erickpires/seven-segments-clock/SevenSegmentClock/SevenSegmentClock.kicad_pcb

## KiCad design SevenSegmentClock/SevenSegmentClock.kicad_pcb (2024-02-11)

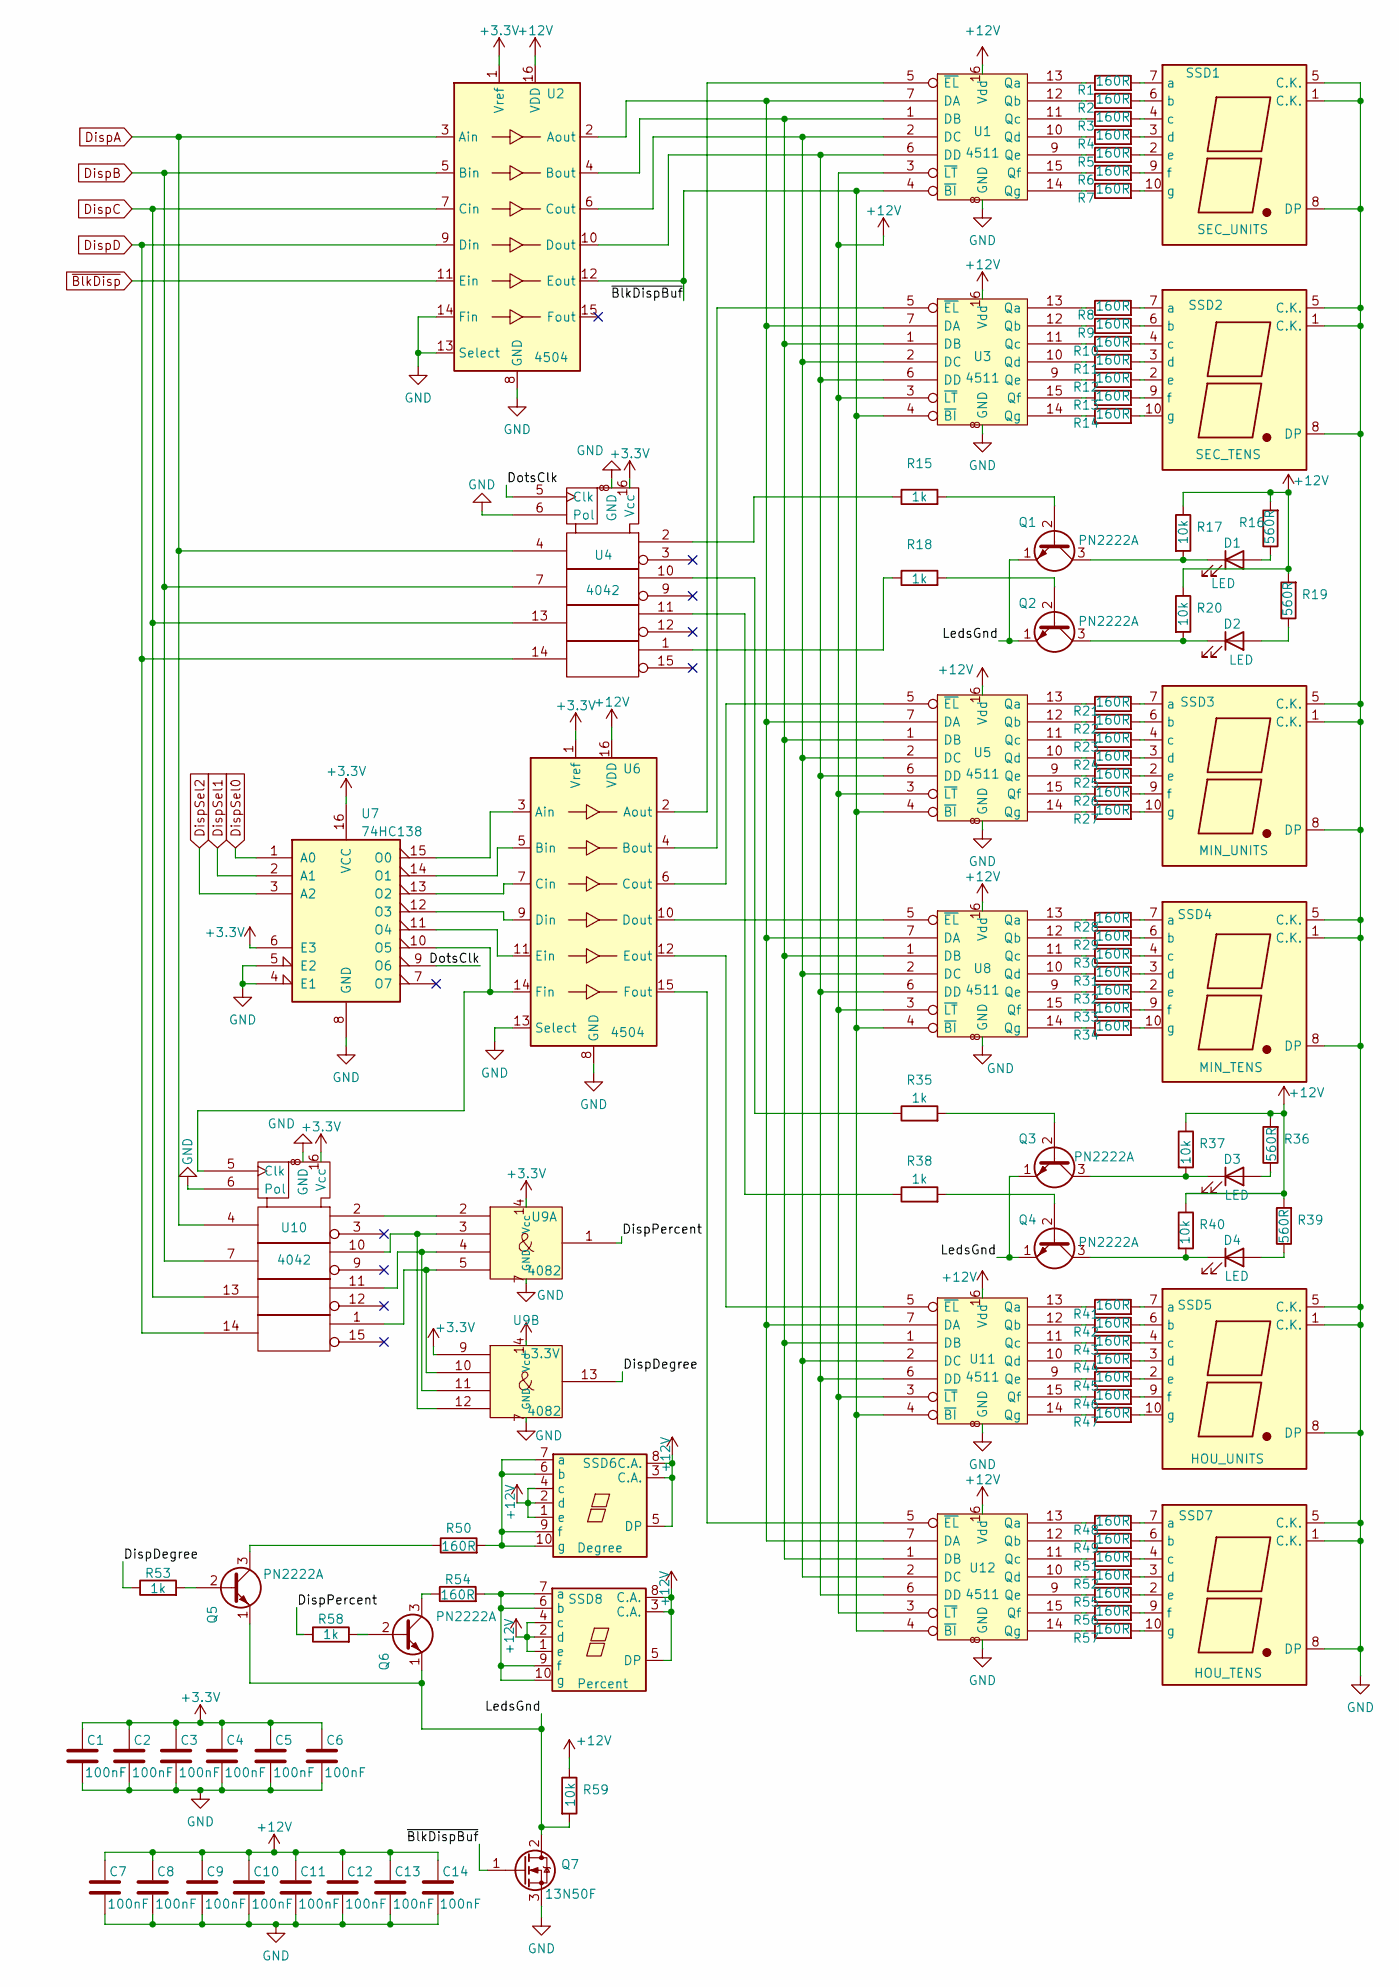
[picture p1: schematic display.kicad_sch]

Parts:
C1, C2, C3, C4, C5, C6, C7, C8, C9, C10, C11, C12, C13, C14: 100nF; C_1206_3216Metric_Pad1.33x1.80mm_HandSolder
D1, D2, D3, D4: LED; LED_D5.0mm
Q1, Q2, Q3, Q4, Q5, Q6: PN2222A; TO-92_Inline
Q7: 13N50F; TO-220-3_Vertical
R1, R2, R3, R4, R5, R6, R7, R8, R9, R10, R11, R12, R13, R14, R21, R22, R23, R24, R25, R26, R27, R28, R29, R30, R31, R32, R33, R34, R41, R42, R43, R44, R45, R46, R47, R48, R49, R50, R51, R52, R54, R55, R56, R57: 160R; R_1206_3216Metric_Pad1.30x1.75mm_HandSolder
R15, R18, R35, R38, R53, R58: 1k; R_1206_3216Metric_Pad1.30x1.75mm_HandSolder
R16, R19, R36, R39: 560R; R_Axial_DIN0207_L6.3mm_D2.5mm_P10.16mm_Horizontal
R17, R20, R37, R40, R59: 10k; R_Axial_DIN0207_L6.3mm_D2.5mm_P10.16mm_Horizontal
SSD1: SEC_UNITS; LSD230A
SSD2: SEC_TENS; LSD230A
SSD3: MIN_UNITS; LSD230A
SSD4: MIN_TENS; LSD230A
SSD5: HOU_UNITS; LSD230A
SSD6: Degree; 7SegmentLED_LTS6760_LTS6780
SSD7: HOU_TENS; LSD230A
SSD8: Percent; 7SegmentLED_LTS6760_LTS6780
U1, U3, U5, U8, U11, U12: 4511; SOIC-16_3.9x9.9mm_P1.27mm
U2, U6: 4504; SOIC-16_3.9x9.9mm_P1.27mm
U4, U10: 4042; DIP-16_W7.62mm_Socket_LongPads
U7: 74HC138; SOIC-16_3.9x9.9mm_P1.27mm
U9: 4082; DIP-14_W7.62mm_Socket_LongPads

Connections:
+3.3V: C1.1, C2.1, C3.1, C4.1, C5.1, C6.1, U2.1 (Vref), U4.16 (Vcc), U6.1 (Vref), U7.6 (E3), U7.16 (VCC), U9.9, U9.14 (Vcc), U10.16 (Vcc); also elsewhere on the board
+12V: C7.1, C8.1, C9.1, C10.1, C11.1, C12.1, C13.1, C14.1, R16.2, R17.1, R19.2, R20.1, R36.2, R37.1, R39.2, R40.1, R59.1, SSD6.1 (e), SSD6.2 (d), SSD6.3 (C.A.), SSD6.4 (c), SSD6.5 (DP), SSD6.8 (C.A.), SSD8.1 (e), SSD8.2 (d), SSD8.3 (C.A.), SSD8.4 (c), SSD8.5 (DP), SSD8.8 (C.A.), U1.3 (~LT), U1.16 (Vdd), U2.16 (VDD), U3.3 (~LT), U3.16 (Vdd), U5.3 (~LT), U5.16 (Vdd), U6.16 (VDD), U8.3 (~LT), U8.16 (Vdd), U11.3 (~LT), U11.16 (Vdd), U12.3 (~LT), U12.16 (Vdd); also elsewhere on the board
/Display/DispDegree: R53.1, U9.13
/Display/DispPercent: R58.1, U9.1
/Display/DotsClk: U4.5 (Clk), U7.9 (O6)
/Display/LedsGnd: Q1.1 (E), Q2.1 (E), Q3.1 (E), Q4.1 (E), Q5.1 (E), Q6.1 (E), Q7.2 (D), R59.2
/Display/~BlkDispBuf: Q7.1 (G), U1.4 (~BI), U2.12 (Eout), U3.4 (~BI), U5.4 (~BI), U8.4 (~BI), U11.4 (~BI), U12.4 (~BI)
DispA: U2.3 (Ain), U4.4, U10.4; also elsewhere on the board
DispB: U2.5 (Bin), U4.7, U10.7; also elsewhere on the board
DispC: U2.7 (Cin), U4.13, U10.13; also elsewhere on the board
DispD: U2.9 (Din), U4.14, U10.14; also elsewhere on the board
DispSel0: U7.1 (A0); also elsewhere on the board
DispSel1: U7.2 (A1); also elsewhere on the board
DispSel2: U7.3 (A2); also elsewhere on the board
GND: C1.2, C2.2, C3.2, C4.2, C5.2, C6.2, C7.2, C8.2, C9.2, C10.2, C11.2, C12.2, C13.2, C14.2, Q7.3 (S), SSD1.1 (C.K.), SSD1.5 (C.K.), SSD1.8 (DP), SSD2.1 (C.K.), SSD2.5 (C.K.), SSD2.8 (DP), SSD3.1 (C.K.), SSD3.5 (C.K.), SSD3.8 (DP), SSD4.1 (C.K.), SSD4.5 (C.K.), SSD4.8 (DP), SSD5.1 (C.K.), SSD5.5 (C.K.), SSD5.8 (DP), SSD7.1 (C.K.), SSD7.5 (C.K.), SSD7.8 (DP), U1.8 (GND), U2.8 (GND), U2.13 (Select), U2.14 (Fin), U3.8 (GND), U4.6 (Pol), U4.8 (GND), U5.8 (GND), U6.8 (GND), U6.13 (Select), U7.4 (E1), U7.5 (E2), U7.8 (GND), U8.8 (GND), U9.7 (GND), U10.6 (Pol), U10.8 (GND), U11.8 (GND), U12.8 (GND); also elsewhere on the board
unnamed: D1.2 (A), R16.1
unnamed: D1.1 (K), Q1.3 (C), R17.2
unnamed: D2.2 (A), R19.1
unnamed: D2.1 (K), Q2.3 (C), R20.2
unnamed: D3.2 (A), R36.1
unnamed: D3.1 (K), Q3.3 (C), R37.2
unnamed: D4.2 (A), R39.1
unnamed: D4.1 (K), Q4.3 (C), R40.2
unnamed: Q1.2 (B), R15.2
unnamed: Q2.2 (B), R18.2
unnamed: Q3.2 (B), R35.2
unnamed: Q4.2 (B), R38.2
unnamed: Q5.2 (B), R53.2
unnamed: Q5.3 (C), R50.1
unnamed: Q6.2 (B), R58.2
unnamed: Q6.3 (C), R54.1
unnamed: R15.1, U4.2
unnamed: R18.1, U4.1
unnamed: R35.1, U4.10
unnamed: R38.1, U4.11
unnamed: R1.2, SSD1.7 (a)
unnamed: R2.2, SSD1.6 (b)
unnamed: R3.2, SSD1.4 (c)
unnamed: R4.2, SSD1.3 (d)
unnamed: R5.2, SSD1.2 (e)
unnamed: R6.2, SSD1.9 (f)
unnamed: R7.2, SSD1.10 (g)
unnamed: R8.2, SSD2.7 (a)
unnamed: R9.2, SSD2.6 (b)
unnamed: R10.2, SSD2.4 (c)
unnamed: R11.2, SSD2.3 (d)
unnamed: R12.2, SSD2.2 (e)
unnamed: R13.2, SSD2.9 (f)
unnamed: R14.2, SSD2.10 (g)
unnamed: R21.2, SSD3.7 (a)
unnamed: R22.2, SSD3.6 (b)
unnamed: R23.2, SSD3.4 (c)
unnamed: R24.2, SSD3.3 (d)
unnamed: R25.2, SSD3.2 (e)
unnamed: R26.2, SSD3.9 (f)
unnamed: R27.2, SSD3.10 (g)
unnamed: R28.2, SSD4.7 (a)
unnamed: R29.2, SSD4.6 (b)
unnamed: R30.2, SSD4.4 (c)
unnamed: R31.2, SSD4.3 (d)
unnamed: R32.2, SSD4.2 (e)
unnamed: R33.2, SSD4.9 (f)
unnamed: R34.2, SSD4.10 (g)
unnamed: R41.2, SSD5.7 (a)
unnamed: R42.2, SSD5.6 (b)
unnamed: R43.2, SSD5.4 (c)
unnamed: R44.2, SSD5.3 (d)
unnamed: R45.2, SSD5.2 (e)
unnamed: R46.2, SSD5.9 (f)
unnamed: R47.2, SSD5.10 (g)
unnamed: R50.2, SSD6.6 (b), SSD6.7 (a), SSD6.9 (f), SSD6.10 (g)
unnamed: R48.2, SSD7.7 (a)
unnamed: R49.2, SSD7.6 (b)
unnamed: R51.2, SSD7.4 (c)
unnamed: R52.2, SSD7.3 (d)
unnamed: R55.2, SSD7.2 (e)
unnamed: R56.2, SSD7.9 (f)
unnamed: R57.2, SSD7.10 (g)
unnamed: R54.2, SSD8.6 (b), SSD8.7 (a), SSD8.9 (f), SSD8.10 (g)
unnamed: U1.7 (DA), U2.2 (Aout), U3.7 (DA), U5.7 (DA), U8.7 (DA), U11.7 (DA), U12.7 (DA)
unnamed: U1.1 (DB), U2.4 (Bout), U3.1 (DB), U5.1 (DB), U8.1 (DB), U11.1 (DB), U12.1 (DB)
unnamed: U1.2 (DC), U2.6 (Cout), U3.2 (DC), U5.2 (DC), U8.2 (DC), U11.2 (DC), U12.2 (DC)
unnamed: U1.6 (DD), U2.10 (Dout), U3.6 (DD), U5.6 (DD), U8.6 (DD), U11.6 (DD), U12.6 (DD)
unnamed: R1.1, U1.13 (Qa)
unnamed: R2.1, U1.12 (Qb)
unnamed: R3.1, U1.11 (Qc)
unnamed: R4.1, U1.10 (Qd)
unnamed: R5.1, U1.9 (Qe)
unnamed: R6.1, U1.15 (Qf)
unnamed: R7.1, U1.14 (Qg)
unnamed: U1.5 (~EL), U6.2 (Aout)
unnamed: R8.1, U3.13 (Qa)
unnamed: R9.1, U3.12 (Qb)
unnamed: R10.1, U3.11 (Qc)
unnamed: R11.1, U3.10 (Qd)
unnamed: R12.1, U3.9 (Qe)
unnamed: R13.1, U3.15 (Qf)
unnamed: R14.1, U3.14 (Qg)
unnamed: U3.5 (~EL), U6.4 (Bout)
unnamed: R21.1, U5.13 (Qa)
unnamed: R22.1, U5.12 (Qb)
unnamed: R23.1, U5.11 (Qc)
unnamed: R24.1, U5.10 (Qd)
unnamed: R25.1, U5.9 (Qe)
unnamed: R26.1, U5.15 (Qf)
unnamed: R27.1, U5.14 (Qg)
unnamed: U5.5 (~EL), U6.6 (Cout)
unnamed: U6.3 (Ain), U7.15 (O0)
unnamed: U6.5 (Bin), U7.14 (O1)
unnamed: U6.7 (Cin), U7.13 (O2)
unnamed: U6.9 (Din), U7.12 (O3)
unnamed: U6.10 (Dout), U8.5 (~EL)
unnamed: U6.11 (Ein), U7.11 (O4)
unnamed: R28.1, U8.13 (Qa)
unnamed: R29.1, U8.12 (Qb)
unnamed: R30.1, U8.11 (Qc)
unnamed: R31.1, U8.10 (Qd)
unnamed: R32.1, U8.9 (Qe)
unnamed: R33.1, U8.15 (Qf)
unnamed: R34.1, U8.14 (Qg)
unnamed: U6.14 (Fin), U7.10 (O5), U10.5 (Clk)
unnamed: U9.5, U9.10, U10.1
unnamed: U9.2, U10.2
unnamed: U9.3, U9.12, U10.10
unnamed: U9.4, U9.11, U10.11
unnamed: R41.1, U11.13 (Qa)
unnamed: R42.1, U11.12 (Qb)
unnamed: R43.1, U11.11 (Qc)
unnamed: R44.1, U11.10 (Qd)
unnamed: R45.1, U11.9 (Qe)
unnamed: R46.1, U11.15 (Qf)
unnamed: R47.1, U11.14 (Qg)
unnamed: U6.12 (Eout), U11.5 (~EL)
unnamed: R48.1, U12.13 (Qa)
unnamed: R49.1, U12.12 (Qb)
unnamed: R51.1, U12.11 (Qc)
unnamed: R52.1, U12.10 (Qd)
unnamed: R55.1, U12.9 (Qe)
unnamed: R56.1, U12.15 (Qf)
unnamed: R57.1, U12.14 (Qg)
unnamed: U6.15 (Fout), U12.5 (~EL)
~BlkDisp: U2.11 (Ein); also elsewhere on the board

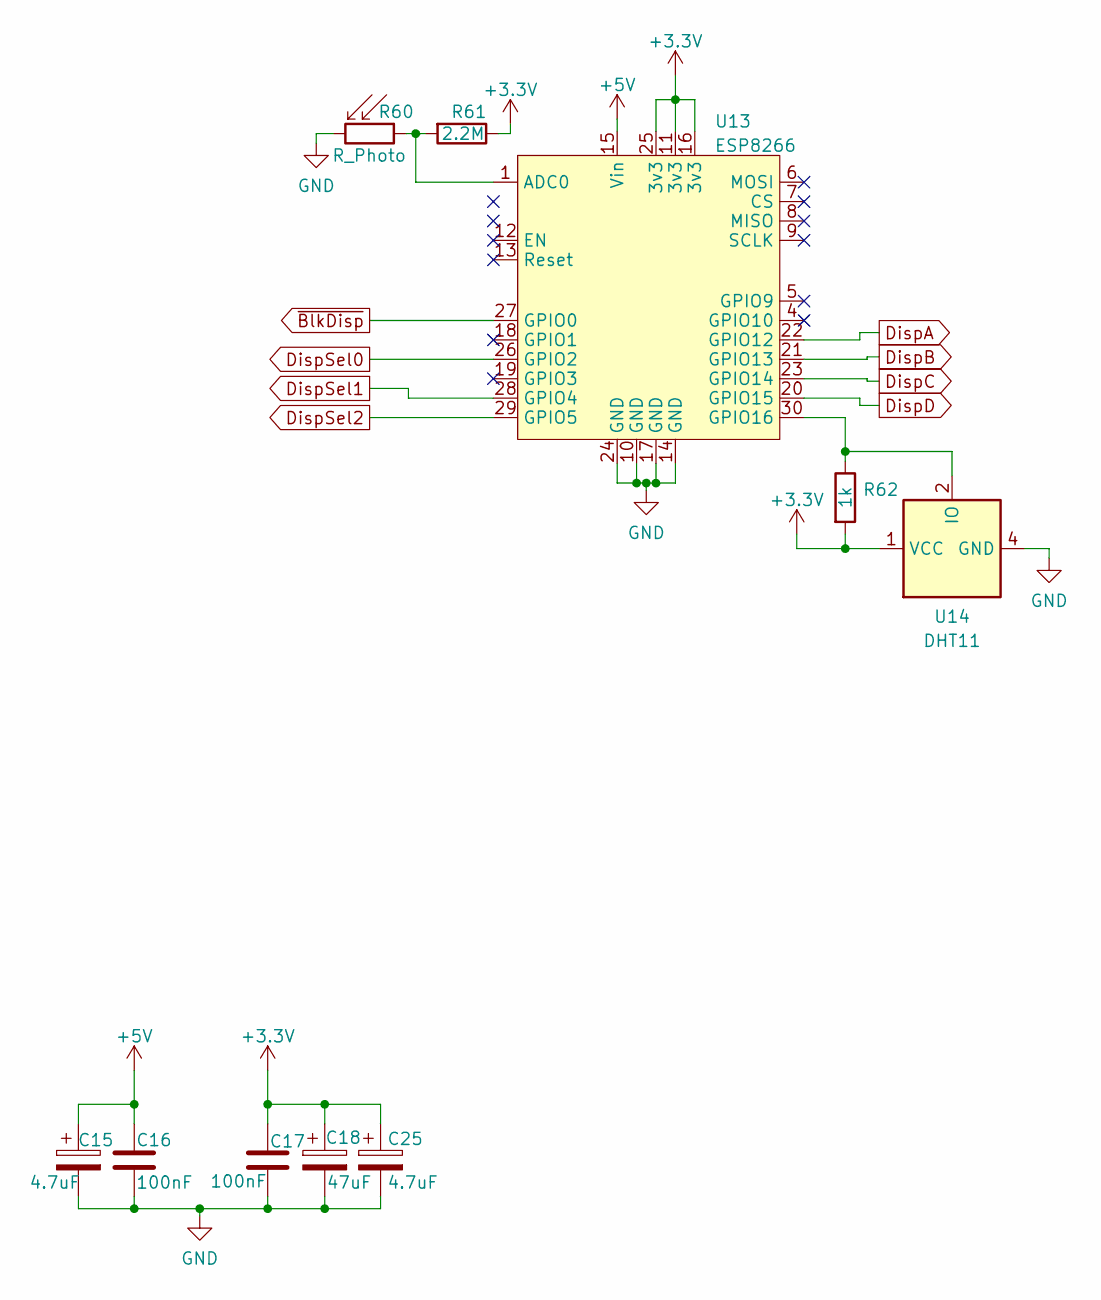
[picture p2: schematic control.kicad_sch]

Parts:
C15, C25: 4.7uF; CP_Radial_D6.3mm_P2.50mm
C16, C17: 100nF; C_1206_3216Metric_Pad1.33x1.80mm_HandSolder
C18: 47uF; CP_Radial_D6.3mm_P2.50mm
R60: R_Photo; R_LDR_4.9x4.2mm_P2.54mm_Vertical
R61: 2.2M; R_Axial_DIN0207_L6.3mm_D2.5mm_P10.16mm_Horizontal
R62: 1k; R_1206_3216Metric_Pad1.30x1.75mm_HandSolder
U13: ESP8266; ESP8266 (NodeMCU_12-E)
U14: DHT11; Aosong_DHT11_5.5x12.0_P2.54mm

Connections:
+3.3V: C17.1, C18.1, C25.1, R61.1, R62.2, U13.11 (3v3), U13.16 (3v3), U13.25 (3v3), U14.1 (VCC); also elsewhere on the board
+5V: C15.1, C16.1, U13.15 (Vin); also elsewhere on the board
DispA: U13.22 (GPIO12); also elsewhere on the board
DispB: U13.21 (GPIO13); also elsewhere on the board
DispC: U13.23 (GPIO14); also elsewhere on the board
DispD: U13.20 (GPIO15); also elsewhere on the board
DispSel0: U13.26 (GPIO2); also elsewhere on the board
DispSel1: U13.28 (GPIO4); also elsewhere on the board
DispSel2: U13.29 (GPIO5); also elsewhere on the board
GND: C15.2, C16.2, C17.2, C18.2, C25.2, R60.2, U13.10 (GND), U13.14 (GND), U13.17 (GND), U13.24 (GND), U14.4 (GND); also elsewhere on the board
unnamed: R60.1, R61.2, U13.1 (ADC0)
unnamed: R62.1, U13.30 (GPIO16), U14.2 (IO)
~BlkDisp: U13.27 (GPIO0); also elsewhere on the board

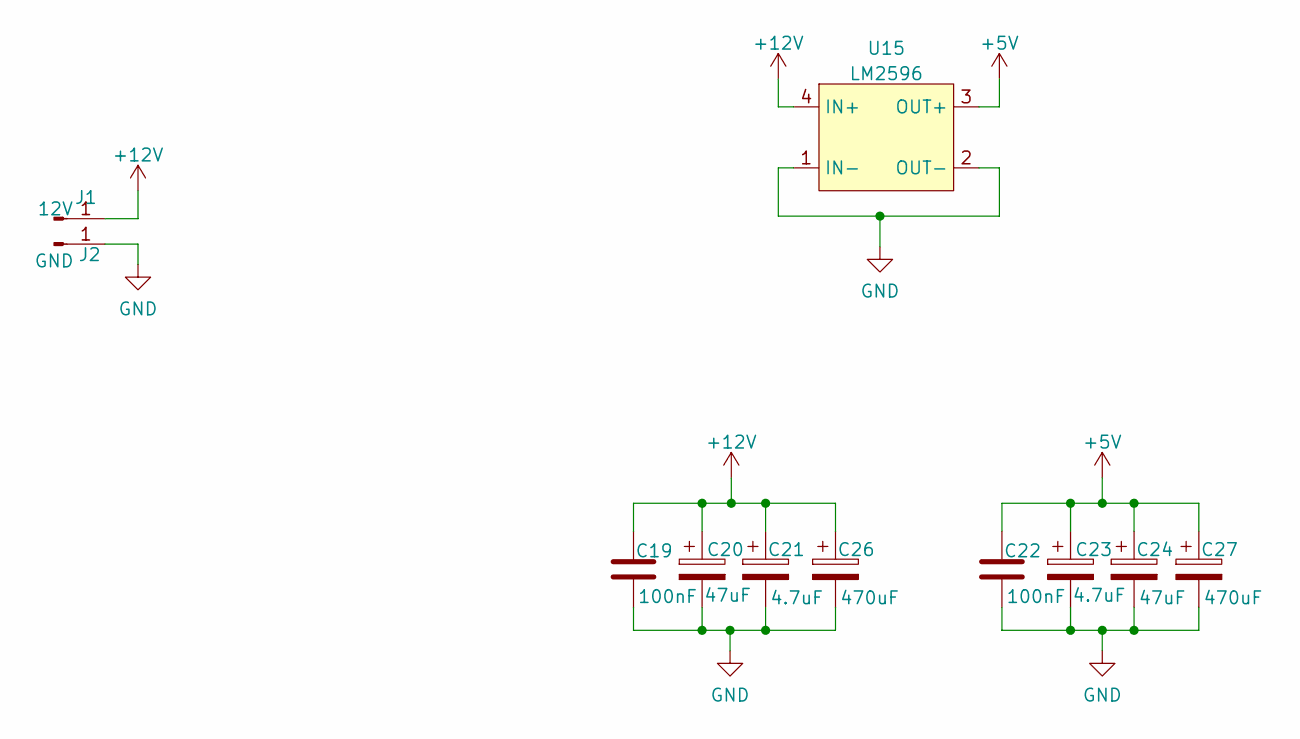
[picture p3: schematic power.kicad_sch]

Parts:
C19, C22: 100nF; C_1206_3216Metric_Pad1.33x1.80mm_HandSolder
C20, C24: 47uF; CP_Radial_D6.3mm_P2.50mm
C21, C23: 4.7uF; CP_Radial_D6.3mm_P2.50mm
C26, C27: 470uF; CP_Radial_D10.0mm_P5.00mm
J1: 12V; PinHeader_1x01_P2.54mm_Vertical
J2: GND; PinHeader_1x01_P2.54mm_Vertical
U15: LM2596

Connections:
+5V: C22.1, C23.1, C24.1, C27.1, U15.3 (OUT+); also elsewhere on the board
+12V: C19.1, C20.1, C21.1, C26.1, J1.1, U15.4 (IN+); also elsewhere on the board
GND: C19.2, C20.2, C21.2, C22.2, C23.2, C24.2, C26.2, C27.2, J2.1, U15.1 (IN-), U15.2 (OUT-); also elsewhere on the board

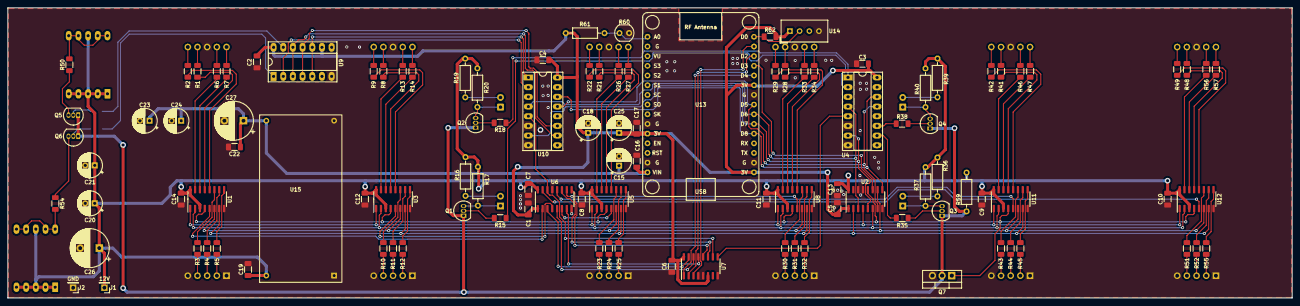
[picture p4: board SevenSegmentClock.kicad_pcb from above]

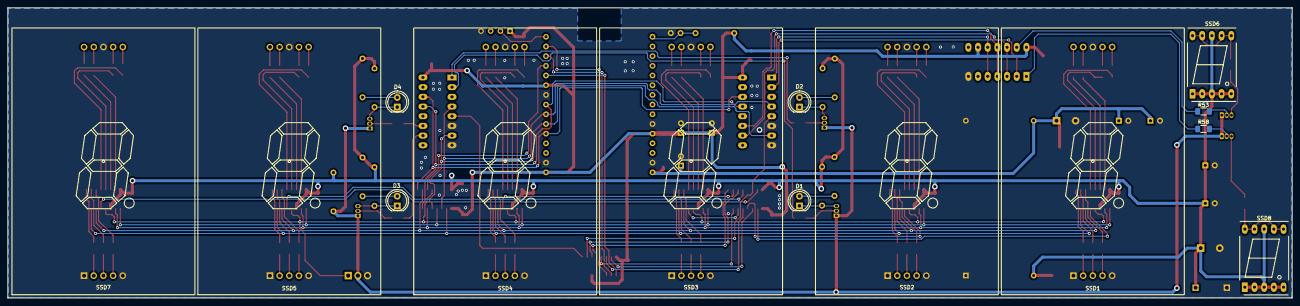
[picture p5: board SevenSegmentClock.kicad_pcb from below]

Board: 2 copper layers, 337.0 x 76.1 mm, 125 parts (14 on the bottom side), 145 nets.
