erickpires/seven-segments-clock/ESP8266/src/Main/types.h

#ifndef M_TYPES_H
#define M_TYPES_H 1

#include <stdint.h>


#include <stdint.h>
#include <stddef.h>
#include <stdbool.h>

typedef intptr_t isize;
typedef int8_t int8;
typedef int16_t int16;
typedef int32_t int32;
typedef int64_t int64;

typedef size_t   usize;
typedef uint8_t  uint8;
typedef uint16_t uint16;
typedef uint32_t uint32;
typedef uint64_t uint64;
typedef unsigned int uint;

#endif
