erickpires/seven-segments-clock/(commit log)

2023-02-06 Starting schematic
    [SevenSegmentClock.csv, SevenSegmentClock.kicad_pcb, SevenSegmentClock.kicad_sch, control.kicad_sch, display.kicad_sch, power.kicad_sch]
2024-02-11 Updating BOM
    [SevenSegmentClock.csv]
2024-02-11 Modifying code to use direct port manipulation
    [SevenSegmentClock.kicad_sch, control.kicad_sch]
2024-02-11 Using SigmaDelta to implement dimming of the display
    [SevenSegmentClock.kicad_sch, display.kicad_sch]
2024-02-11 Adding two more displays to show a degree and a percent symbols
    [SevenSegmentClock.kicad_sch, control.kicad_sch, display.kicad_sch, power.kicad_sch]
2024-02-11 Adding the control schematic and fixing Eletrical Rules Checks
    [SevenSegmentClock.kicad_sch, control.kicad_sch, display.kicad_sch, power.kicad_sch]
2024-02-11 Assigning footprints
    [SevenSegmentClock.kicad_sch, control.kicad_sch, display.kicad_sch, power.kicad_sch]
2024-02-11 Fixing incorrect footprints
    [SevenSegmentClock.kicad_pcb, SevenSegmentClock.kicad_sch, control.kicad_sch, display.kicad_sch]
2024-02-11 The 560R resistor was not available in a SMD package
    [SevenSegmentClock.kicad_pcb, SevenSegmentClock.kicad_sch, display.kicad_sch]
2024-02-11 WIP: PCB Design
    [SevenSegmentClock.kicad_pcb, display.kicad_sch]
2024-02-11 Better routing
    [SevenSegmentClock.kicad_pcb]
2024-02-11 Ground fill and DRC fixes
    [SevenSegmentClock.kicad_pcb]
2024-02-11 Finishing PCB design
    [SevenSegmentClock.kicad_pcb]
2024-02-11 Gerber files
    [SevenSegmentClock-B_Cu.gbr, SevenSegmentClock-B_Mask.gbr, SevenSegmentClock-B_Paste.gbr, SevenSegmentClock-B_Silkscreen.gbr, SevenSegmentClock-Edge_Cuts.gbr, SevenSegmentClock-F_Cu.gbr, SevenSegmentClock-F_Mask.gbr, SevenSegmentClock-F_Paste.gbr]
2024-02-11 Updating to newer kicad
    [SevenSegmentClock.csv, SevenSegmentClock.kicad_pcb, SevenSegmentClock.kicad_sch, control.kicad_sch, display.kicad_sch, power.kicad_sch]
2024-02-11 Swapping around percentage and degree indicators
    [SevenSegmentClock.kicad_pcb, display.kicad_sch]
2024-02-11 Fixing the display masks and adding the other digits
    [Main.ino, display.cpp, display.h]
2024-02-11 Cleaning up the display code and displaying date, temperature and humidity
2024-02-11 Fixing the polarity of the CD4042s
    [SevenSegmentClock.kicad_pcb, display.kicad_sch]
2024-02-11 Moving configuration code to a dedicated file
    [configuration-server.h]
2024-02-11 Refactoring the configuration server code
    [configuration-server.h]
2024-02-11 Saving the device configuration in the EEPROM
    [configuration-manager.h, configuration-server.h, configuration.h]
2024-02-20 Passing the sensor pin and the sensor type at the DHT class construction
2024-02-20 Reading the DHT sensor every 2 seconds since even the DHT11 can handle a 0.5Hz refresh rate
